sushrutmair/lpg-leak-detect-iot/README.md

# lpg-leak-detect-iot
NodeMCU based LPG leak detector:

An IoT system for detecting household gas leakage. It has two files:

lpg-leak-detect.ino - Node MCU code

lpgmon_client.py - Python program that communicates with the Node MCU and stores LPG level data to disk
