sushrutmair/lpg-leak-detect-iot/docs/assets/video_preload.jpg

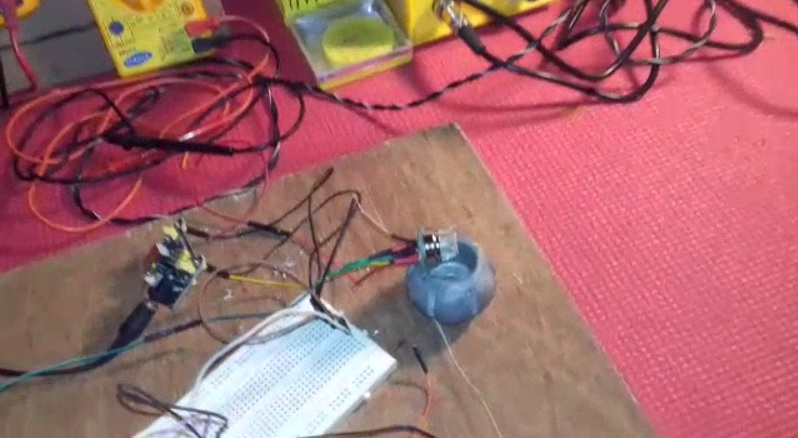
docs/assets/video_preload.jpg
