sushrutmair/lpg-leak-detect-iot/(commit log)

2018-10-14 Added main source file
    This file has been built under the Arduino IDE 1..2 or greater hence the .ino extension. The underlying hardware is the Node MCU 1.0.
2018-10-16 Added csv's in a folder
    [lpgmon_01082018a.csv, lpgmon_27072018a.csv, lpgmon_30072018a.csv, lpgmon_31072018a.csv, lpgmon_cy_29072018.csv]
